DavidyKwok/Multistage-Amplifier/ELE 404 Final Lab.pdf

Table of Contents

### 1. Introduction | P3

### 2. Design and Calculation Summary | P3

### 3. Multisim Simulations | P4

### 4. Experimental Results | P8

### 5. Conclusions and Remarks | P8

### 6. Appendix-Calculations | P9

P2

### 1. Introduction

The purpose of this design project is to design a multistage amplifier circuit that meets all the requirements listed below. This project was simulated using multisim and the calculations for designing the amplifier are found in the appendix.

Specifications:
- Power supply: +10V relative to the ground
- Quiescent current drawn from the power supply: no larger than 10 mA;
- No-load voltage gain (at 1 kHz): |Avo| = 50 (± 10%);
- Maximum no-load output voltage swing (at 1 kHz): no smaller than 8 V peak to peak;
- Loaded voltage gain (at 1 kHz and with RL = 1 kΩ): no smaller than 90% of the no-load voltage gain;
- Maximum loaded output voltage swing (at 1 kHz and RL = 1 kΩ): no smaller than 4 V peak to peak;
- Input resistance (at 1 kHz): no smaller than 20 kΩ;
- Amplifier type: inverting or non-inverting;
- Frequency response: 20 Hz to 50 kHz (−3dB response);
- Type of transistors: BJT;
- Number of transistors (stages): no more than 3;
- Resistances permitted: values smaller than 220 kΩ from the E24 series;
- Capacitors permitted: 0. 1 μF, 1. 0 μF, 2. 2 μF, 4. 7 μF, 10 μF, 47 μF, 100 μF, 220 μF;
- Other components (BJTs, diodes, Zener diodes, etc.): only from your ELE404 lab kit.
- The output voltage must be free from distortions (clipping, etc.) in all test conditions.
- The source resistance, Rs, must be 600 Ω for all tests.

### 2. Design and Calculation Summary:

The amplifier design chosen was a multistage amplifier consisting of 3 stages. The first stage and second stage were common emitter amplifiers while the last stage was an emitter follower amplifier. The reason for choosing the first 2 stages to be an common emitter amplifier instead of an common base or emitter follower was because of the requirement of input resistance no smaller than 20kΩ and the need for a 50 voltage gain. With a common base amplifier, since the input source is connected to the emitter of the BJT, the input resistance will be low. This is because the input resistance of a common base amplifier is based on the resistance of the emitter which is approximately less than 1kΩ. An emitter follower was not used in the first 2 stages because the maximum gain from an emitter follower is only 1. This results in the only suitable amplifier being the common emitter for the first 2 stages. For the final stage, an emitter follower is needed to allow the load resistor to be connected without losing gain. The load resistor only being a 1kΩ results in the loss of gain since Rout needs to be smaller than RL. For a common emitter amplifier, the Rout is typically too large and will cause a loss of gain. However, in an emitter follower configuration where Rout = 1/gm , the low output resistance helps maintain gain even with small load values.

When designing the first stage, the goal was to have a voltage gain of around 10. To do this, the theoretical gain was set to around 12 since the Rin of the second stage will lower the gain. The resistors RC1 and RE1 were calculated to be around 12kΩ and 1kΩ respectively through a ratio related the two with the theoretical voltage gain. The VCE1 was also calculated to be 5V as the DC operating voltage is known to be around half of the supply voltage. The quiescent current was calculated using the load line equation and assumptions were made to calculate the rest of the currents IR2

, IB1

,and IE1

. IR1 was calculated using a KCL at VB1

. With all these values
calculated, the rest of the resistance values R1 and R2 were calculated. Finally the input resistance was calculated using a KCL at the VE. For stage 2, the same process was used to calculate all the resistor values.

When designing the last stage, the quiescent current was estimated to be 8.9 mA which is close to the limit of 10 mA, resistor RE3 was estimated to be around 680Ω, and R5 was estimated to be 36kΩ. With these estimated values, gm3

, IE3

, IB3

, VE3

, VB3

, and rbe3 were calculated. The remaining resistor R6 was calculated using a KCL at the node VB3

. The input resistance was final calculated it the values to be around 23737Ω. The capacitance values were determined using the impedance formula for a capacitor. For the capacitance to be decided, the impedance must be small when applying both the minimum and maximum frequencies. This is to ensure that the capacitors won’t affect the gain in AC. The value that was chosen for the impedance was 100µF as the output impedance was around 80Ω on the minimum frequency and 0.03Ω on maximum frequency. These resistances are very small so the capacitors won’t impact the gain.

### 3. Multisim Simulations:

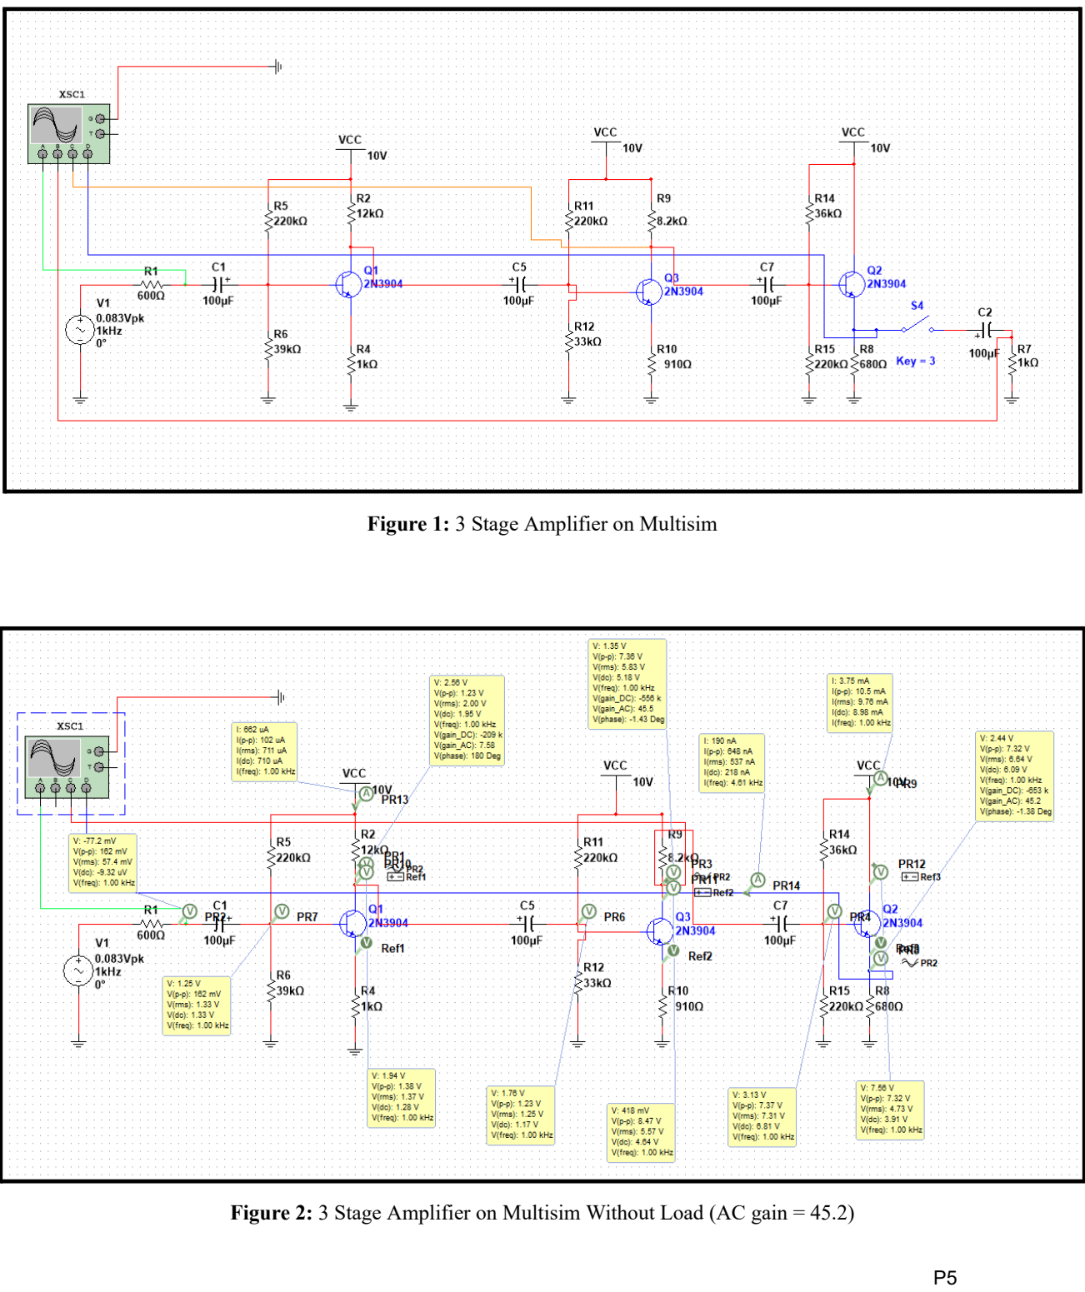
[picture p1: page 4]

Figure 1: 3 Stage Amplifier on Multisim

Figure 2: 3 Stage Amplifier on Multisim Without Load (AC gain = 45.2)

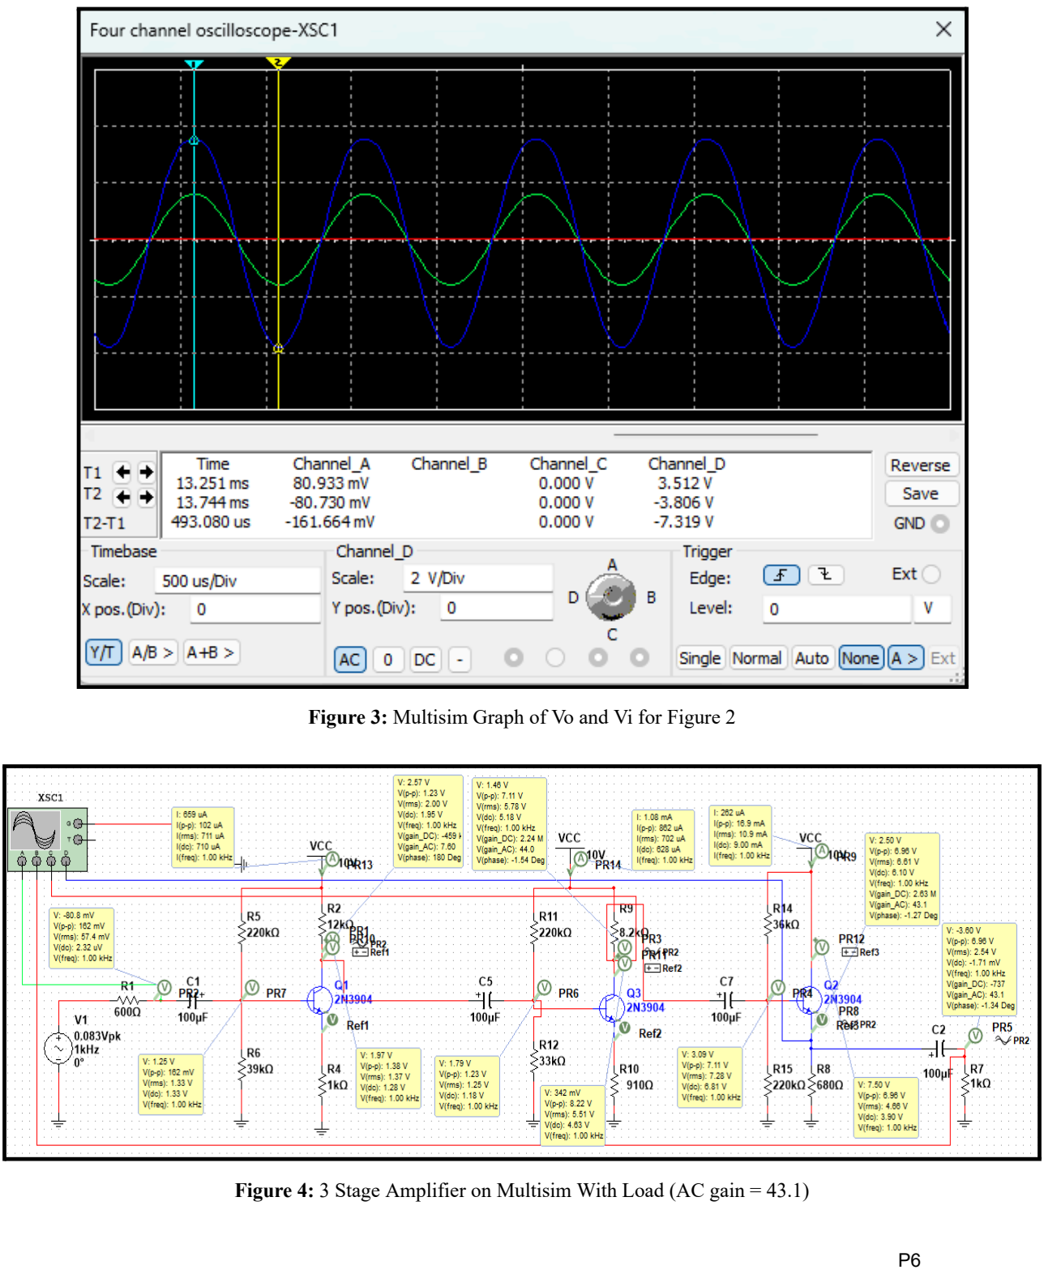
[picture p2: page 5]

Figure 3: Multisim Graph of Vo and Vi for Figure 2

Figure 4: 3 Stage Amplifier on Multisim With Load (AC gain = 43.1)

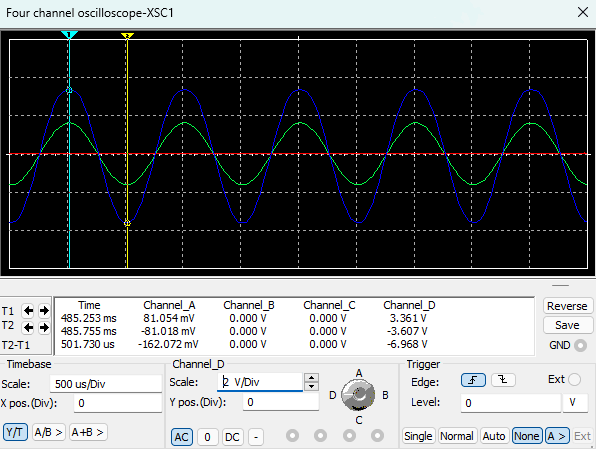
[picture p3: figure]

Figure 5: Multisim Graph of Vo and Vi for Figure 4

When the circuit is tested without load and Vs is set to 0.083v peak to peak, the resulting Vo is 7.32v peak to peak which is close to the required 8v peak to peak. The voltage gain is also around 45.2 which meets the requirement of within 10% of a 50 gain. When the circuit is tested with the load, the resulting Vo is 6.96 which is above the requirement of over 4v peak to peak. The gain is also around 43.1 which is within the required 90% of the gain without load. The simulated currents were around 710µA, 628µA, and 9mA all below 10mA which meets the requirements. The input resistances for each stage were 33120Ω, 28689Ω, and 23737Ω respectively which are all above 20kΩ, meeting the requirements. Below are all the values calculated and simulated for comparison.

### 4. Experimental Results:

Table 1: All the Simulated and Theoretical Results for Figure 2
Values | Simulated | Theoretical
VB1 | 1.33v | 1.0846v
VB2 | 1.17v | 1.199v
VB3 | 6.81v | 6.752v
VE1 | 0.372v | 0.385v
VE2 | 0.541v | 0.4994v
VE3 | 6.09v | 6.052v
IC1 | 710µA | 385µA
IC2 | 628µA | 550µA
IC3 | 9mA | 8.9mA
AV1 | -7.58 | -7.951
AV2 | -6.00 | -6.3838
AV3 | 0.994 | 0.996

### 5. Conclusions and Remarks

To summarize the project, the multistage amplifier that was created used a common emitter for the first two stages and an emitter follower for the last stage. This amplifier met most of the requirements with gain around 45.2 without load which is within the 10% of 50 gain requirement and 43.1 with load which is within the 90% of gain without load requirement. The no load output voltage was around 7.32v peak to peak which doesn’t meet the 8v peak to peak requirement although it is close and the output voltage with the load was around 6.96 which meets the requirement of 4v peak to peak or above. The quiescent currents were around 710µA, 628µA, and 9mA which meet the requirement of the currents being below 10mA. The capacitors were chosen to be 100µF which meet the frequency response requirement of 20Hz and 50kHz. The input resistances for each stage were 33120Ω, 28689Ω, and 23737Ω respectively which meets the requirement of input resistances having to be above 20kΩ. There are some discrepancies in comparing the simulated and theoretical results in Table 1 which could be from the assumptions made in the calculations and some errors made due to rounding. Despite the fact that the output voltage without load didn’t reach 8v peak to peak , the rest of the values met the requirements so the project was still successful.

### 5. Appendix-Calculations

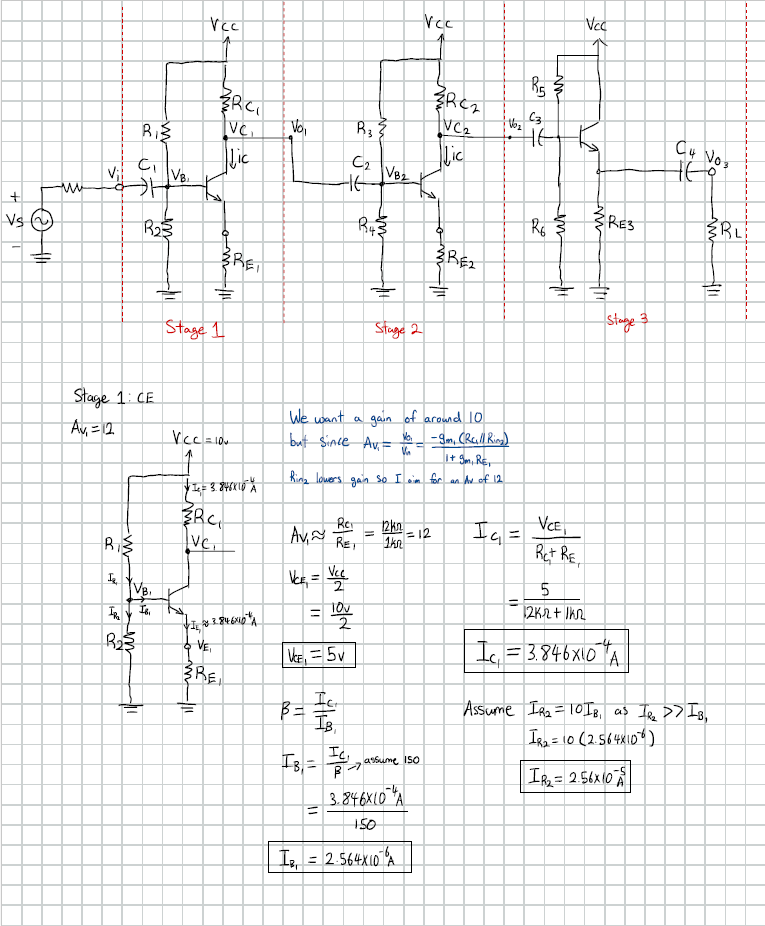
[picture p4: figure]

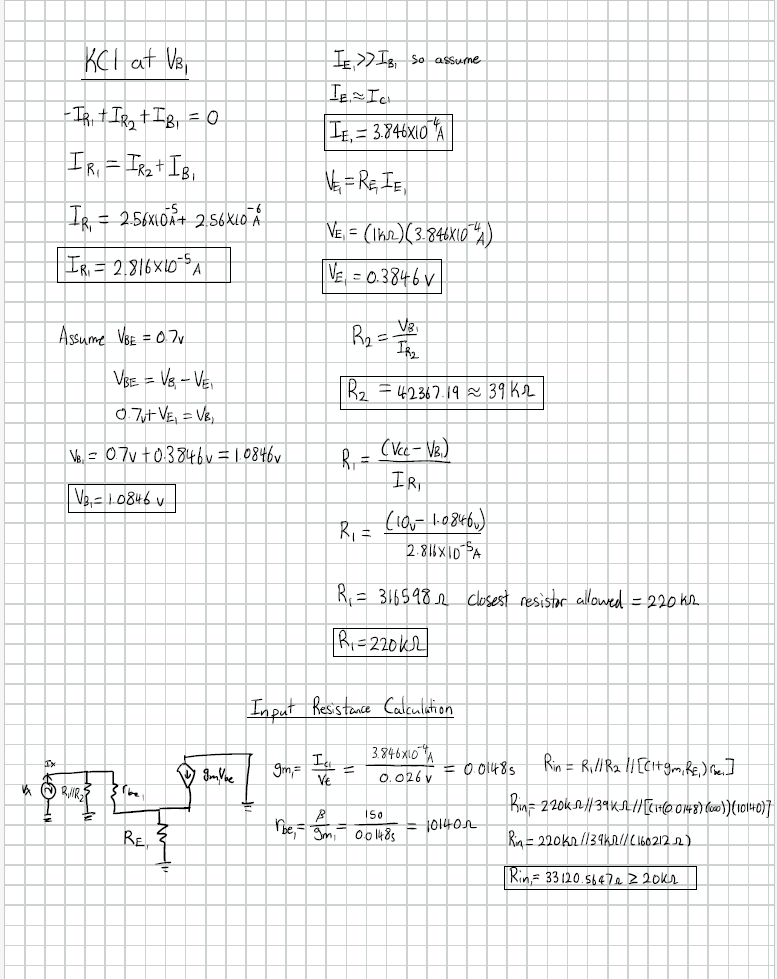
[picture p5: figure]

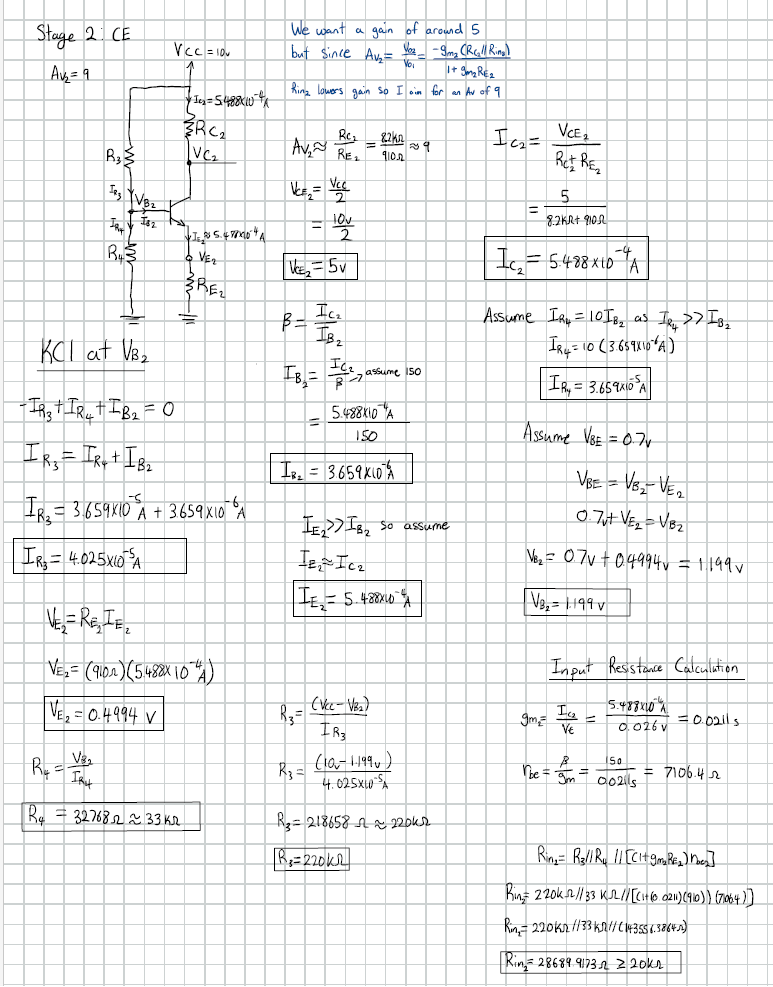
[picture p6: figure]

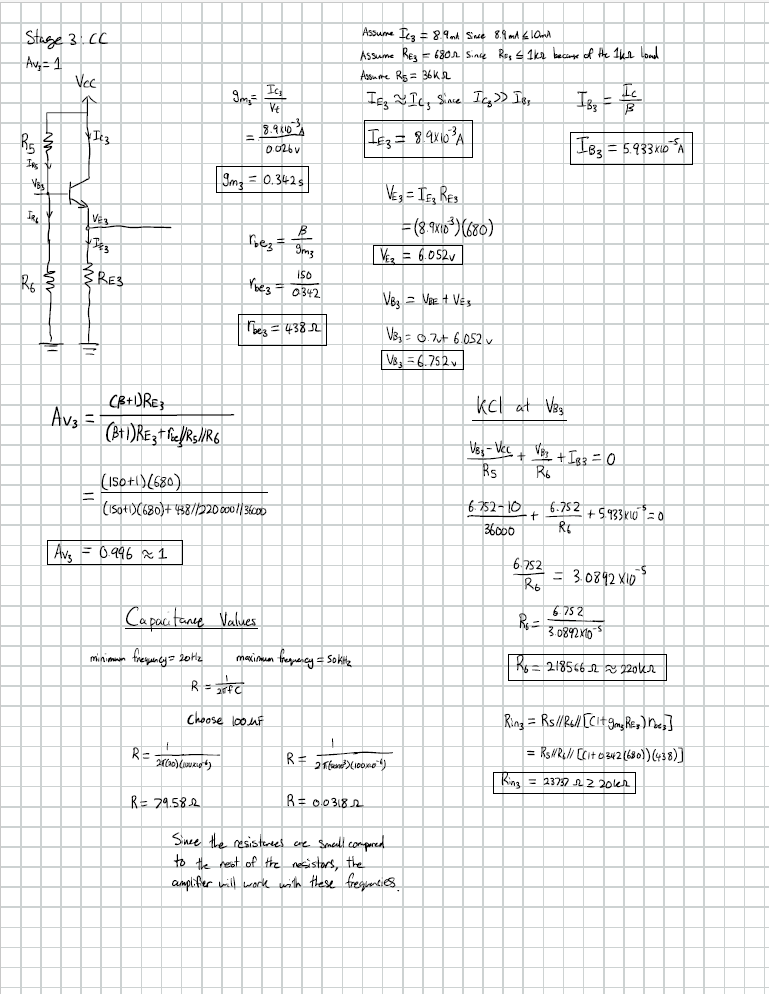
[picture p7: figure]

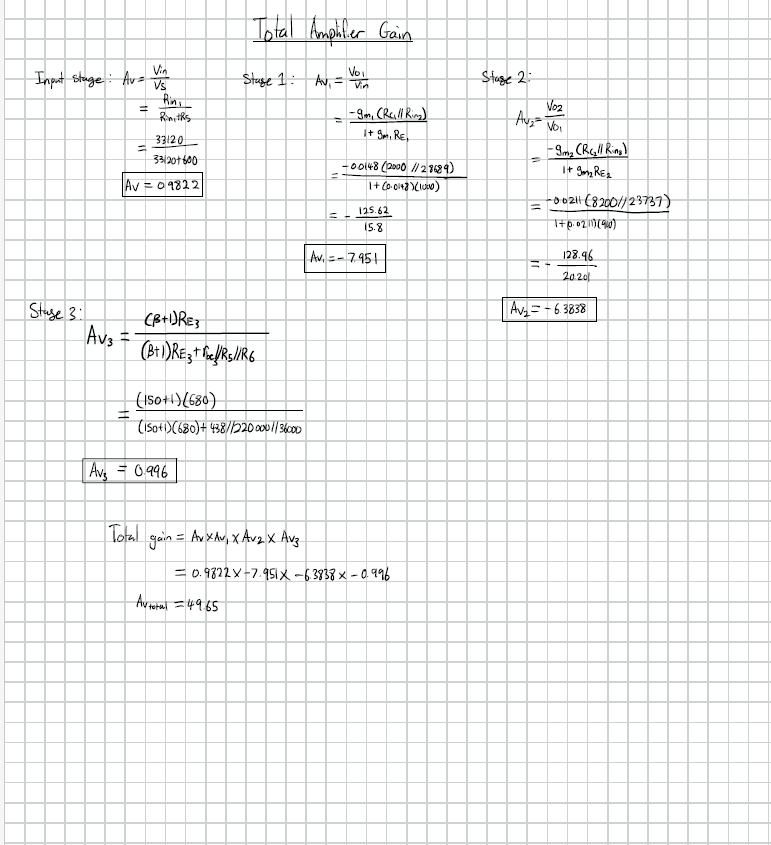
[picture p8: figure]
