DavidyKwok/Multistage-Amplifier/(list of files, drawings)

Other design files:
Final Project Multisim.ms14
